idubrov/x2-feed/pcb/current/x2-feed.brd

## EAGLE design pcb/current/x2-feed.brd (2017-05-27)

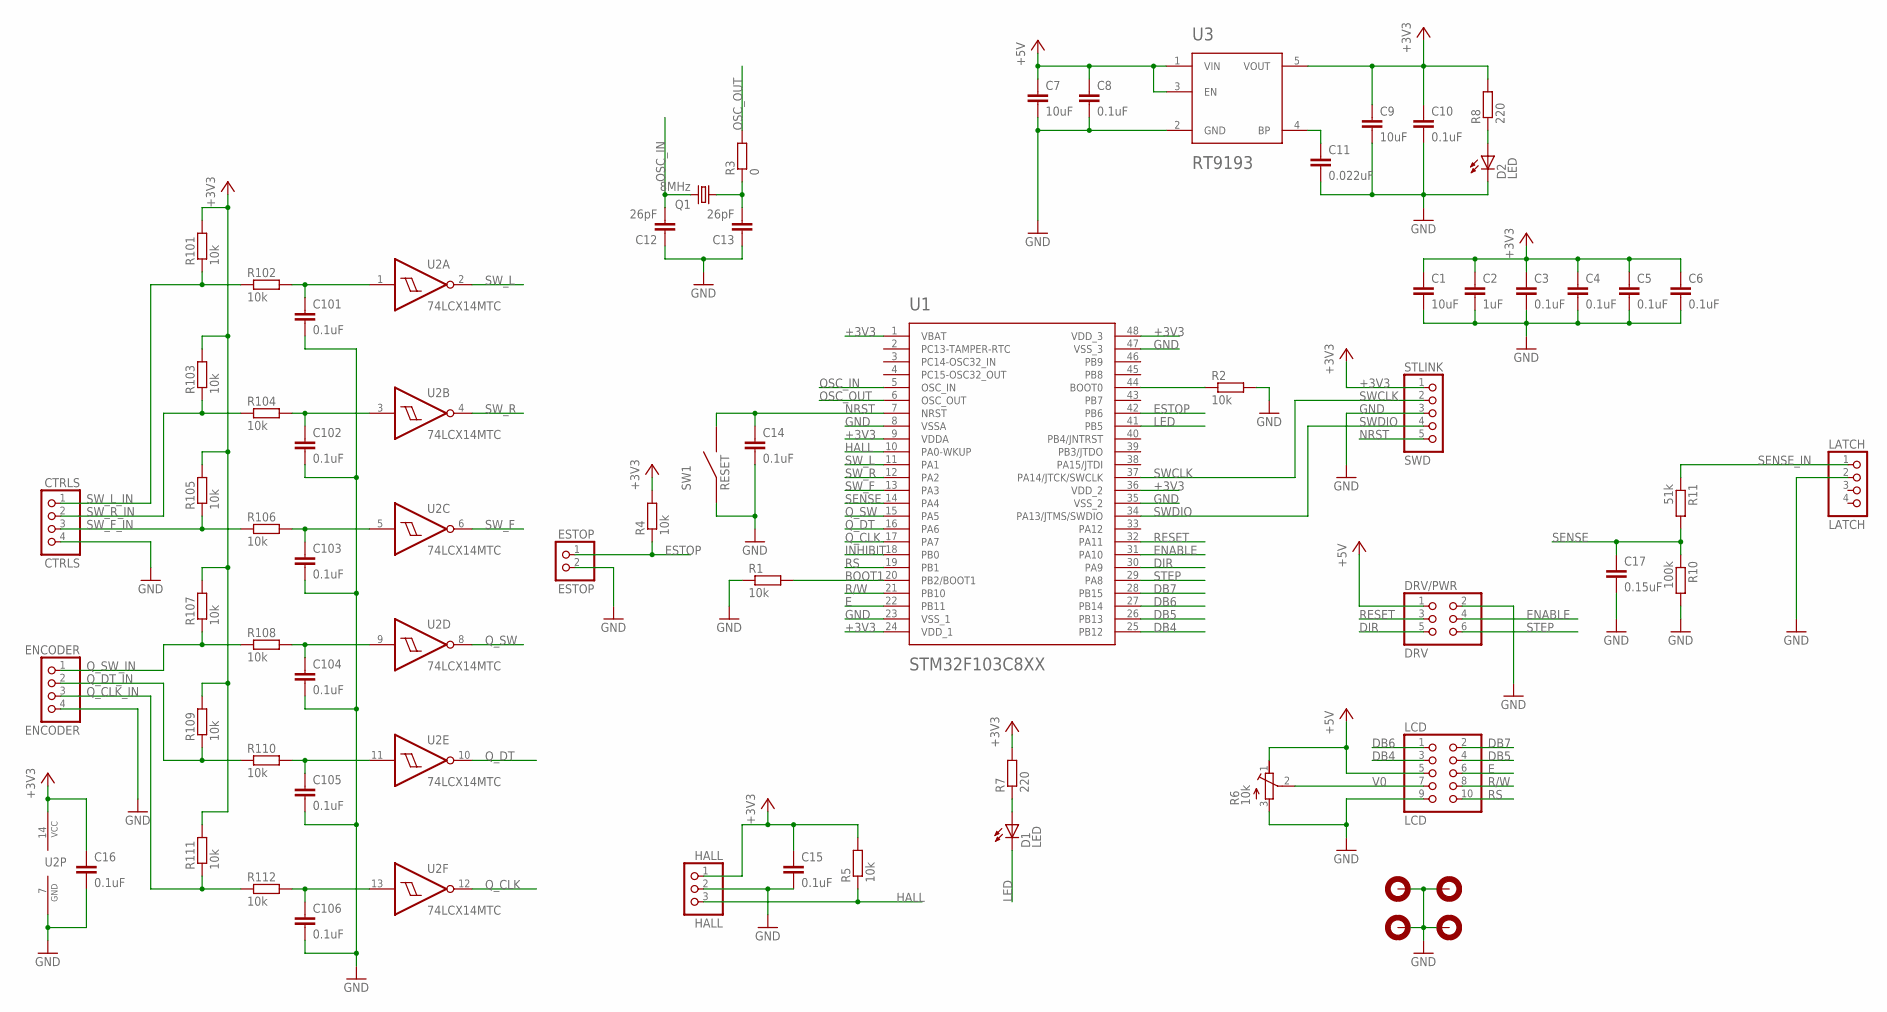
[picture p1: schematic x2-feed.sch]

Parts:
C1, C7, C9: 10uF; C2012
C2: 1uF; C1608
C3, C4, C5, C6, C8, C10, C14, C15, C16, C101, C102, C103, C104, C105, C106: 0.1uF; C1608
C11: 0.022uF; C1608
C12, C13: 26pF; C1608
C17: 0.15uF; C1608
CTRLS: CTRLS; 1X04
D1, D2: LED; LED2012
DRV/PWR: DRV; 2X03
ENCODER: ENCODER; 1X04
ESTOP: ESTOP; 1X02
H1, H2, H3, H4: MOUNT-PAD-ROUND2.8; 2,8-PAD
HALL: HALL; 5-103361-1
LATCH: LATCH; 1X04
LCD: LCD; 2X05
Q1: 8MHz; HC49/S
R1, R2, R4, R5, R101, R102, R103, R104, R105, R106, R107, R108, R109, R110, R111, R112: 10k; R1608
R3: 0; R1608
R6: 10k; RTRIMT93YA
R7, R8: 220; R1608
R10: 100k; R1608
R11: 51k; R1608
STLINK: SWD; 1X05
SW1: RESET; PUSH
U1: STM32F103C8XX; LQFP48-7X7MM
U2: 74LCX14MTC; TSSOP14
U3: RT9193; SOT23-5L

Connections:
+3V3: C1.1, C2.1, C3.1, C4.1, C5.1, C6.1, C9.1, C10.1, C15.1, C16.1, HALL.1, R4.2, R5.2, R7.2, R8.2, R101.2, R103.2, R105.2, R107.2, R109.2, R111.2, STLINK.1, U1.1 (VBAT), U1.9 (VDDA), U1.24 (VDD_1), U1.36 (VDD_2), U1.48 (VDD_3), U2.14 (VCC), U3.5 (VOUT)
+5V: C7.1, C8.1, DRV/PWR.1, LCD.5, R6.1 (E), U3.1 (VIN), U3.3 (EN)
BOOT0: R2.1, U1.44 (BOOT0)
BOOT1: R1.2, U1.20 (PB2/BOOT1)
BP: C11.1, U3.4 (BP)
DB4: LCD.3, U1.25 (PB12)
DB5: LCD.4, U1.26 (PB13)
DB6: LCD.1, U1.27 (PB14)
DB7: LCD.2, U1.28 (PB15)
DIR: DRV/PWR.5, U1.30 (PA9)
E: LCD.6, U1.22 (PB11)
ENABLE: DRV/PWR.4, U1.31 (PA10)
ESTOP: ESTOP.1, R4.1, U1.42 (PB6)
GND: C1.2, C2.2, C3.2, C4.2, C5.2, C6.2, C7.2, C8.2, C9.2, C10.2, C11.2, C12.1, C13.1, C14.2, C15.2, C16.2, C17.2, C101.2, C102.2, C103.2, C104.2, C105.2, C106.2, CTRLS.4, D2.C, DRV/PWR.2, ENCODER.4, ESTOP.2, H1.B2,8, H2.B2,8, H3.B2,8, H4.B2,8, HALL.2, LATCH.2, LCD.9, R1.1, R2.2, R6.3 (A), R10.2, STLINK.3, SW1.1, SW1.2 (1), U1.8 (VSSA), U1.23 (VSS_1), U1.35 (VSS_2), U1.47 (VSS_3), U2.7 (GND), U3.2 (GND)
HALL: HALL.3, R5.1, U1.10 (PA0-WKUP)
INHIBIT: U1.18 (PB0)
LED: D1.C, U1.41 (PB5)
unnamed: C13.2, Q1.1, R3.1
unnamed: D1.A, R7.1
unnamed: C101.1, R102.2, U2.1 (I)
unnamed: D2.A, R8.1
unnamed: C102.1, R104.2, U2.3 (I)
unnamed: C103.1, R106.2, U2.5 (I)
unnamed: C104.1, R108.2, U2.9 (I)
unnamed: C105.1, R110.2, U2.11 (I)
unnamed: C106.1, R112.2, U2.13 (I)
NRST: C14.1, STLINK.5, SW1.3 (2), SW1.4 (2), U1.7 (NRST)
OSC_IN: C12.2, Q1.2, U1.5 (OSC_IN)
OSC_OUT: R3.2, U1.6 (OSC_OUT)
Q_CLK: U1.17 (PA7), U2.12 (O)
Q_CLK_IN: ENCODER.3, R111.1, R112.1
Q_DT: U1.16 (PA6), U2.10 (O)
Q_DT_IN: ENCODER.2, R109.1, R110.1
Q_SW: U1.15 (PA5), U2.8 (O)
Q_SW_IN: ENCODER.1, R107.1, R108.1
R/W: LCD.8, U1.21 (PB10)
RESET: DRV/PWR.3, U1.32 (PA11)
RS: LCD.10, U1.19 (PB1)
SENSE: C17.1, R10.1, R11.2, U1.14 (PA4)
SENSE_IN: LATCH.1, R11.1
STEP: DRV/PWR.6, U1.29 (PA8)
SWCLK: STLINK.2, U1.37 (PA14/JTCK/SWCLK)
SWDIO: STLINK.4, U1.34 (PA13/JTMS/SWDIO)
SW_F: U1.13 (PA3), U2.6 (O)
SW_F_IN: CTRLS.3, R105.1, R106.1
SW_L: U1.11 (PA1), U2.2 (O)
SW_L_IN: CTRLS.1, R101.1, R102.1
SW_R: U1.12 (PA2), U2.4 (O)
SW_R_IN: CTRLS.2, R103.1, R104.1
V0: LCD.7, R6.2 (S)

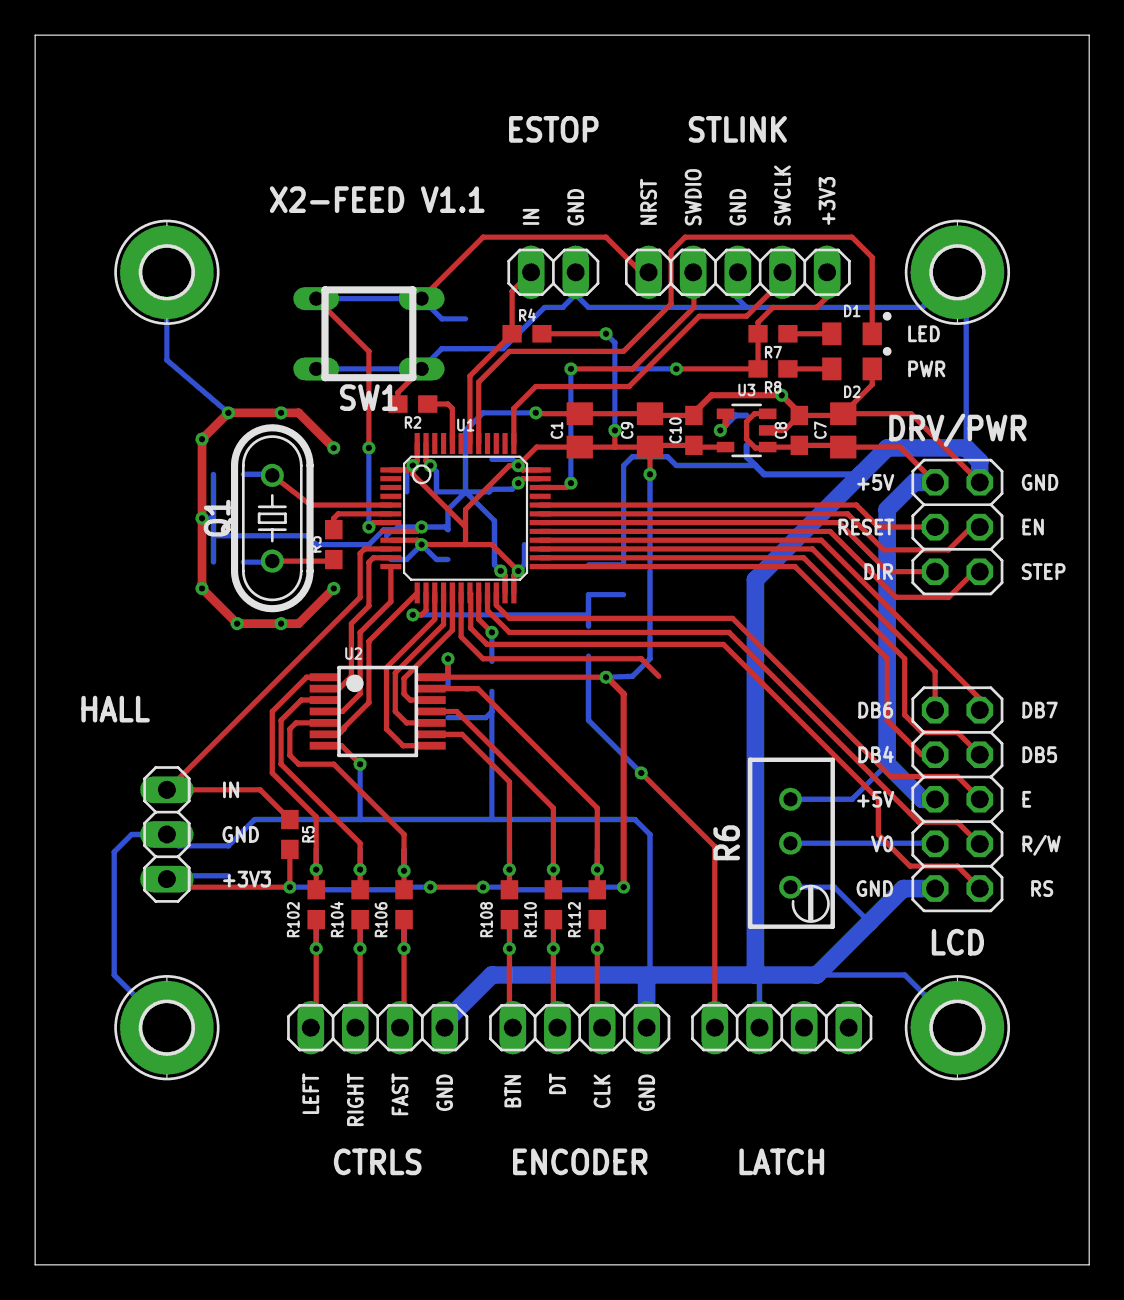
[picture p2: board x2-feed.brd from above]

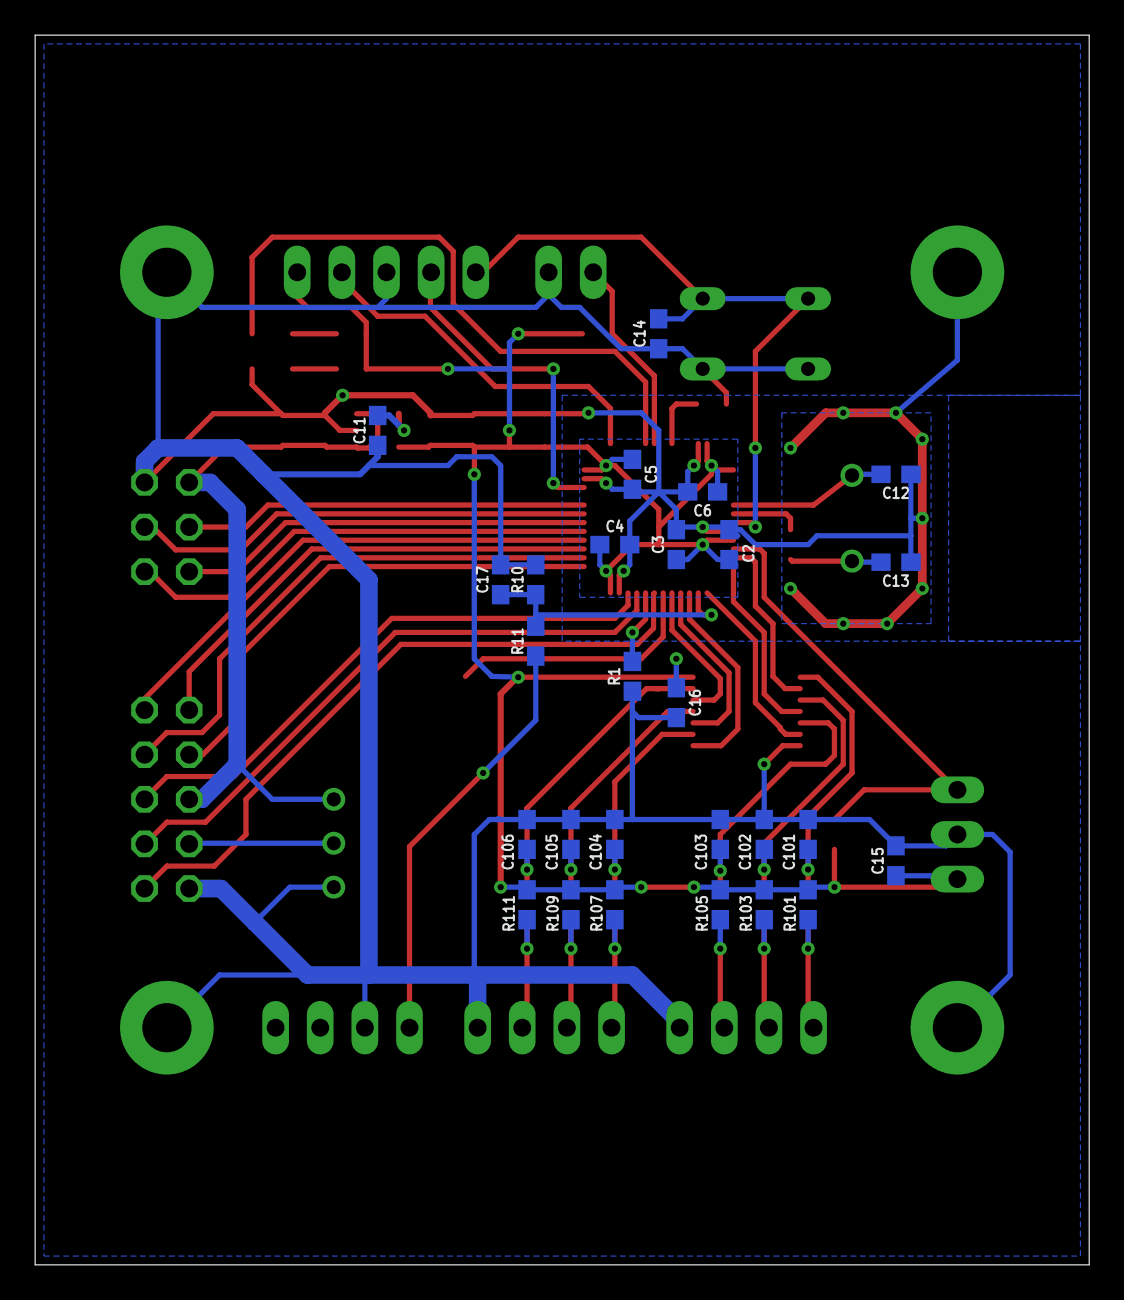
[picture p3: board x2-feed.brd from below]

Board: 2 copper layers, 60.0 x 70.0 mm, 64 parts (27 on the bottom side), 49 nets.
