idubrov/x2-feed/(commit log)

2017-05-25 Initial version of X2 PowerFeed and Motor Control
    [x2-feed.brd, x2-feed.sch]
2017-05-27 LCD screen added
    [x2-feed.brd]
2017-05-27 Adding support for rotary encoder
2017-05-29 Started working on driver
2017-05-29 Working on driver
2017-05-29 Working on powerfeed
2017-05-29 Implementing power feed algorithm
2017-05-30 Adding RPM sensor support
    * Hall-sensor based tachometer
2017-05-30 Fixing deadlock situation
    When checking if driver is stopped, don't wait for update flag to reset.
    This operation is currently only called when update interrupt is disabled,
    so it will never reset.
    [driver.rs]
2017-06-06 Changing formatting of IPM/RPM
    Also, fixing bug in hall.rs.
    [main.rs]
2017-09-09 Fixing warnings when using latest nightly Rust
    [clock.rs, main.rs, mod.rs]
2017-09-19 Continuing HAL refactoring
    * Encoder, controls and led.
2017-09-19 Starting heavy refactoring of stepper/driver
    Trying to separate `hw` module from `hal` module. `hal` is for
    interfaces to the hardware whereas `hw` is for bindings to the
    concrete hardware.
    [controls.rs, driver.rs, led.rs, main.rs, mod.rs, screen.rs, stepper.rs]
2017-09-19 Working on better separation between step controller and stepper driver
2017-09-20 Refactoring hall sensor and quad encoder
2017-09-26 Converting screen to use stm32-extras
    Also, changing timer not to change SYST register
2017-09-26 Fixing clippy errors; minor doc update
    [clock.rs, delay.rs]
2017-09-26 Converting controls to stm32-extras
2017-09-27 Fixing dependency; minor tweaks
    [main.rs, rpm.rs]
2017-09-30 Started working on menu system
    Also, updating for the latest stm32-hal module and adding support for EEPROM.
2017-09-30 Reworking stepper state a little
    [feed.rs, stepper.rs]
2017-10-01 Custom panic function; don't capture driver when not needed
2017-10-01 Fixing clippy warning; minor comment tweak
    [feed.rs]
2017-10-25 Print error on panic
    [main.rs]
2017-10-25 Better handling of slow/fast errors; fixing overflow bug
    [feed.rs]
2017-10-25 Handle stepgen errors; different exit condition
    Making long pressing of encoder to be an exit condition from the menu.
    [clock.rs, delay.rs, feed.rs, main.rs, mod.rs, stepper.rs, util.rs]
2017-10-25 Started working on limits; fixing error handling in stepper a little
    [feed.rs, stepper.rs]
2017-10-26 Fixing bugs
    * Fixing navigation in feed
    * Fixing stepper not setting state to stopped when going to given position
    * Setting traversal speed when setting limits
    [feed.rs, limits.rs, main.rs, stepper.rs, util.rs]
2021-12-29 Working on thread cutting
2022-01-02 switching to HAL
2022-01-02 Switching encoder to use 4 ticks per step
    Switching encoder to use 4 ticks per step instead of 2 so we can
    have a bit of hysteresis action.
2022-01-02 Switching to STM32F1XX hal
2022-01-03 Converting to HAL; fixing issue with encoder
    [controls.rs, driver.rs, encoder.rs, led.rs, main.rs, rpm.rs]
2022-01-04 Switching back to external crates; github action
